sreejithmunthikodu/Mechatronics-MASc-Course-Project/final_design_report.pdf

### University of Victoria

Department of Mechanical Engineering

MECH 458/554 - Mechatronics

# Design and Implementation of an Inspection System Using an ATMEL AVR Microcontroller

# Final Design Report

Rushi Nathvani

V00835408

Sreejith Munthikodu

V00903589

## April 19, 2018

# Abstract

Modern embedded systems have become a vital part of our daily life with their applications ranging from

portable devices such as digital watches and digital cameras to large and complex installations such as traffic

lights, washing machines, and automotive systems. The objective of this design project was to design a high-

performance inspection system, implement the proposed design using an ATMEL AVR microcontroller and to

demonstrate it’s functionality. The inspection system was required to sort given number of items based on the

visual and material characteristics in a minimum amount of time. The project required to use the advanced

microcontroller functionalities such as Interrupts, Timers, Pulse Width Modulation (PWM) and Analog to

Digital Converters (ADC). Also, advanced programming skills were required to implement functions such as

First-In-First-Out (FIFO) dynamic linked list using C-language. Moreover, the project demanded using various

sensors such as inductance and reflectance sensors, and actuators such as a DC motor to drive the conveyor

belt and a stepper motor to rotate the bin to collect the sorted items.

# Acknowledgments

This highly challenging embedded system design project would not have been possible without the ample

guidance of course instructor Mr. Yuanye Chen and lab instructor Mr. Patrick Chang. The concepts required to

complete the project were effectively introduced in sequence in the class and the same was implemented during

the weekly lab sessions. So by the end of lab 4, we could gain a lot of knowledge about the microcontrollers

and their functionalities and we were in a position to start our design project with confidence.

We are highly grateful to Mr. Patrick Chang for patiently listening to all our queries and guiding us to find

the right answers from the manual. He sacrificed his weekends and opened the lab on all the weekends which

helped us to spend more time on our project and complete it in time. We would like to thank the University of

Victoria and the Department of Mechanical Engineering for offering such a valuable course, for providing us the

technical manuals and access to the Mechatronics lab and for providing other infrastructures such as the library,

which helped us to successfully complete this design project. Also, we would like to extend our gratitude to all

the Teaching Assistants for helping us to complete our lab works and for extending their support in evaluating

assignments, supervising the exams and for evaluating the demonstration of the inspection system. Finally, we

would like to thank our coursemates for being kind enough to share the limited available stations and other

resources at the lab.

# Contents

## Page

List of Figures | i
List of Tables | i
1 Introduction | 1
2 Project Timeline | 4
3 Methods and Design Approach | 4
4 System Technical Details | 6
5 System Performance Specifications | 11
6 Testing and Calibration Procedures | 12
7 Limitations and System Trade-offs | 13
8 Novel System Additions | 13
9 Experience and Recommendations | 14
10 Conclusion | 15
11 References | 15
Appendix A | Summary of Contributions
Appendix B | Source Code

# List of Figures

## Page

1 | ATMEL AT90USB 1287 MCU | | 2
2 | Model of the conveyor system and inspection stations | | 2
3 | Project timeline | | 4
4 | Block diagram of complete system | | 6
5 | Circuit diagram of complete system | | 7
6 | System algorithm/flowchart | | 8
7 | LCD pins | | 14

# List of Tables

## Page

1 | LCD pin descriptions | | 14
2 | Summary of contributions | A – 1

i

# 1 Introduction

## 1.1 Problem Statement

The objective of this design project was to design a high-performance inspection system, implement the pro-

posed design using an ATMEL AVR microcontroller and demonstrate it’s functionality. The inspection system

was required to sort four types of cylindrically shaped objects which were either black plastic, white plastic,

steel, or aluminum material. For the final performance testing, the inspection system needed to sort 48 of

such items into their respective bins in less than 60 seconds. Also, there had to be a pause button which

paused the inspection system and a ramp-down button which stopped the system after sorting all the items

on the conveyor. The details such as the number of each item sorted and unsorted items on the belt were to

be displayed using LEDs or optionally using LCD display.

## 1.2 Design Purpose and Overview

The purpose of this design project was to classify and sort 48 cylindrical shaped items which were either black

plastic, white plastic, steel, or aluminum in less than 60 seconds. Additionally, a pause button and a system

ramp-down button were required to interrupt the system. The AT90USB 1287 microcontroller was used as

the heart of the sorting system. A conveyor belt driven by a DC motor was used to carry the items to be

sorted through various sensor stations. The sensor stations were used to identify the correct type of the item.

Finally, a stepper motor driven bin was used to collect the sorted items while they fell off the conveyor belt.

The various components used in the design are described below.

## 1.2.1 AT90USB 1287 Microcontroller

The high-performance, low-power Microchip 8-bit AVR microcontroller combines 128KB ISP flash memory with

read-while-write capabilities, 8KB SRAM, 48 general purpose I/O lines, 32 general purpose working registers,

real-time counter, four flexible timer/counters with compare modes and PWM, USB 2.0 low-speed and full-

speed On-The-Go (OTG) host/device, an 8-channel 10-bit A/D converter, JTAG (IEEE 1149.1 compliant)

interface for on-chip debugging, and six software selectable power saving modes. An image of the MCU is

shown in Figure 1.

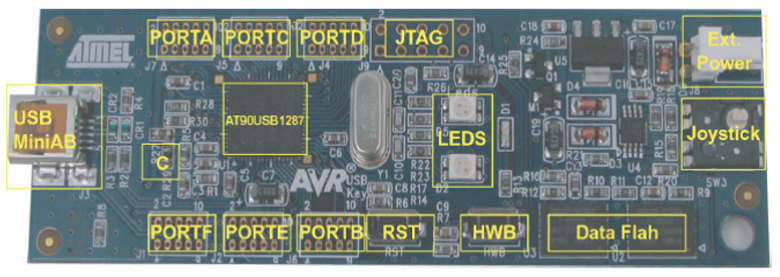
[picture p1: figure]

## Figure 1: ATMEL AT90USB 1287 MCU

## 1.2.2 Conveyor System

A conveyor belt was used to transport the items that were to be sorted. It was driven by a DC motor and

the speed of the conveyor was controlled by the PWM signal. Guides were provided at the loading point of

the conveyor which aligned the loaded items on the belt and ensured that there was a sufficient gap between

adjacent items for the sensors to read correctly. The belt could be started or stopped as required but the speed

of the belt was to be constant during the operation. A model of the system is shown in Figure 2.

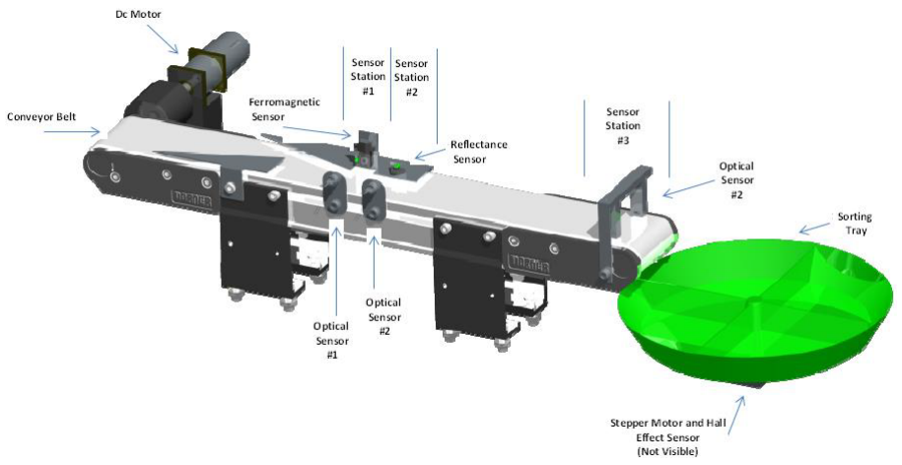
[picture p2: figure]

## Figure 2: Model of the conveyor system and inspection stations

## 1.2.3 Inspection Stations

As the items traveled on the conveyor belt, they passed through various sensor stations which classified the

material and visual characteristics of the items. Three sensors were used in this project to determine the type

of the items.

## - Pre-reflectance Optical Sensor:

It is a digital sensor which is active high. It was used to identify if an item was in the range of the

reflectance sensor. Only when an object was between the pre-reflectance optical sensor and the reflectance

sensor, the analog signal was measured and converted into a digital value.

## - Reflectance Sensor:

It is an analog sensor which measured the reflectance of the item in its range. Based on the visual and

material characteristics, different types of items have their unique range of reflectance value which can

be used to identify the type of the item.

## 1.2.4 Sorting System

There is an exit optical sensor placed near the end of the conveyor belt system. If an item was detected by

the exit optical sensor, which is an active low digital sensor, it indicated that the item has reached the end of

travel. There was a rotating bin below the end of travel which could collect the falling items. If the item at

the end of travel didn’t match the respective tray bin, the belt was stopped and the tray rotated to the correct

bin before starting the belt again and allowing the item to fall down. The location of the bin was identified

by using a Hall-Effect sensor, which set the bin to its home position before the start of the inspection. The

positions of other bins on the tray were defined relative to the home position. The two sensors used in the

## sorting system can be summarized as below:

## - Exit Optical Sensor

It is an active low digital sensor which indicates that the item has reached the end of travel.

## - Hall-Effect Sensor

It is an active low digital sensor that sets the sorting tray to its home position.

# 2 Project Timeline

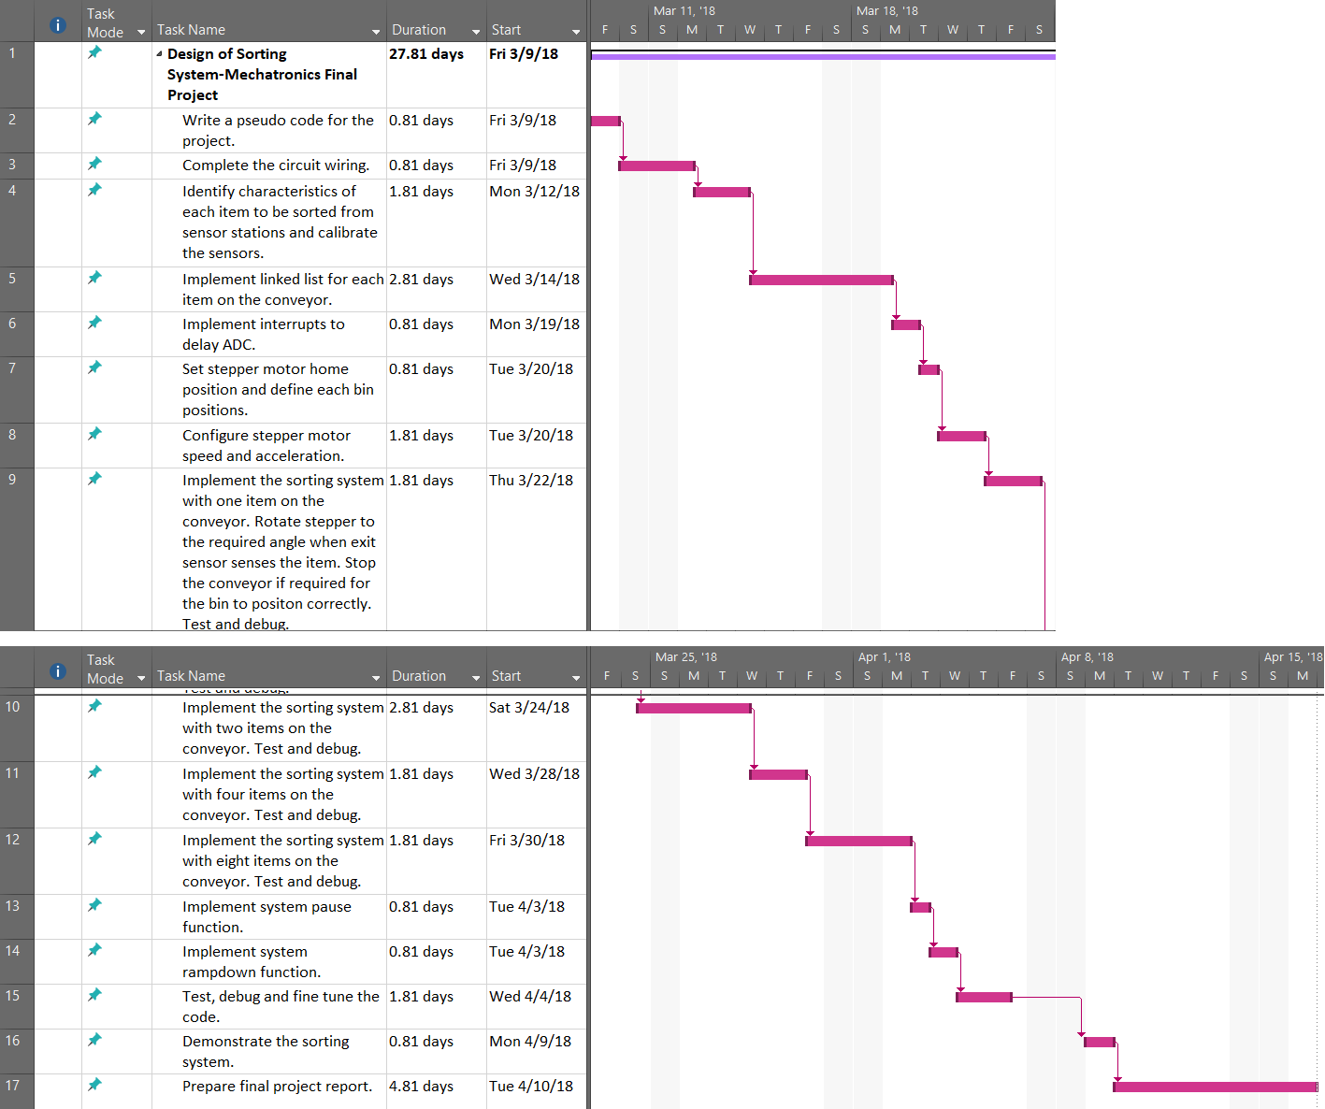
[picture p3: figure]

## Figure 3: Project timeline

# 3 Methods and Design Approach

The design demands a careful coordination of the DC motor, different sensor stations and the stepper motor

for correctly sorting the items on the conveyor. The items were loaded onto the conveyor belt which took them

through the sensor stations. The first sensor station detected the type of the item and the exit sensor station

made sure that the tray was positioned correctly before the item was allowed to fall down into the bin.

The conveyor belt was driven by a DC motor using PWM signal. The speed of the DC motor was controlled

by the width of the PWM signal. The speed was optimized for minimum traveling time with the time available

for the ADC as a constraint. Having a faster belt speed resulted in overlapping ADC reflectance values for the different objects and hence resulted in identifying incorrect object type. Also, at very high speed, when

the belt was stopped at the exit sensor, the object sometimes slipped and fell into the incorrect bin due to the

higher inertia caused by the faster belt speed.

The reflectance sensor was primarily used to identify the type of the item. It is an analog sensor and hence

Analogue to Digital Conversions were required. A 10-bit ADC resolution was used in this project. Since the

ADC consumes considerable process cycles, the pre-reflectance optical sensor was used to ensure that the ADC

started only when an item was present in the range of the reflectance sensor. As the items moved through

the belt and reached the first sensor station, which was the pre-reflectance optical sensor and the reflectance

sensor, ADC was started and the minimum value of the ADC result was stored. As the item left the first

sensor station and traveled on its way to the exit sensor, the MCU compared the minimum ADC result value

with that of the range of each item to be sorted and identified the object type. A dynamic FIFO linked list

was created and the object type was enqueued.

When the object reached the exit optical sensor station, the first item in the linked list was dequeued and the

object type was read. The object type is counted using a different variable to update the total number of each

item sorted and to identify the number of items remaining on the belt. The object type of the dequeued item

was compared with the current tray position. If the tray position matched that of the object type, the item

was allowed to fall into the correct bin without stopping the conveyor belt. If the current bin did not match

the object type, the belt was stopped and a command was given to the stepper motor to rotate the tray to the

correct bin. Once the correct bin was positioned, the belt was started and the object allowed to fall into the

correct bin.

The Hall-Effect sensor set the home position of the bin which was black. Other bin positions were defined

relative to the home position and the stepper was turned 90 degrees clockwise, 90 degrees counterclockwise or

180 degrees as required to set the bin to the correct position before the object was dropped.

The design is mainly interrupt driven. A large chunk of the code is executed inside the interrupts. The first

interrupt is triggered when the item is detected by the pre-reflectance optical sensor. The second interrupt is

triggered when an ADC is completed. A third interrupt is triggered when the object is detected by the exit

optical sensor. The fourth and fifth interrupts are used for the system pause button and system ramp-down

button respectively.

For the system pause, a push-button triggered an interrupt on rising edge when activated. When the pushbutton

is pressed and released, the interrupt stops the conveyor belt immediately and displays the information such as

the number of each object type sorted and the total number of items remaining on the belt. When the button

is pressed and released again, the belt resumes and the system continues to sort items.

Another pushbutton was used for the system ramp-down function. When the interrupt is triggered by the

pushbutton, the systems starts counting and after a set delay the belt is stopped and the sorted item information

is displayed on the LCD screen. The delay in stopping the conveyor belt ensures that all items remaining on

the belt while the system ramp-down is initiated, are sorted before shutting down the system.

# 4 System Technical Details

## 4.1 Block Diagram

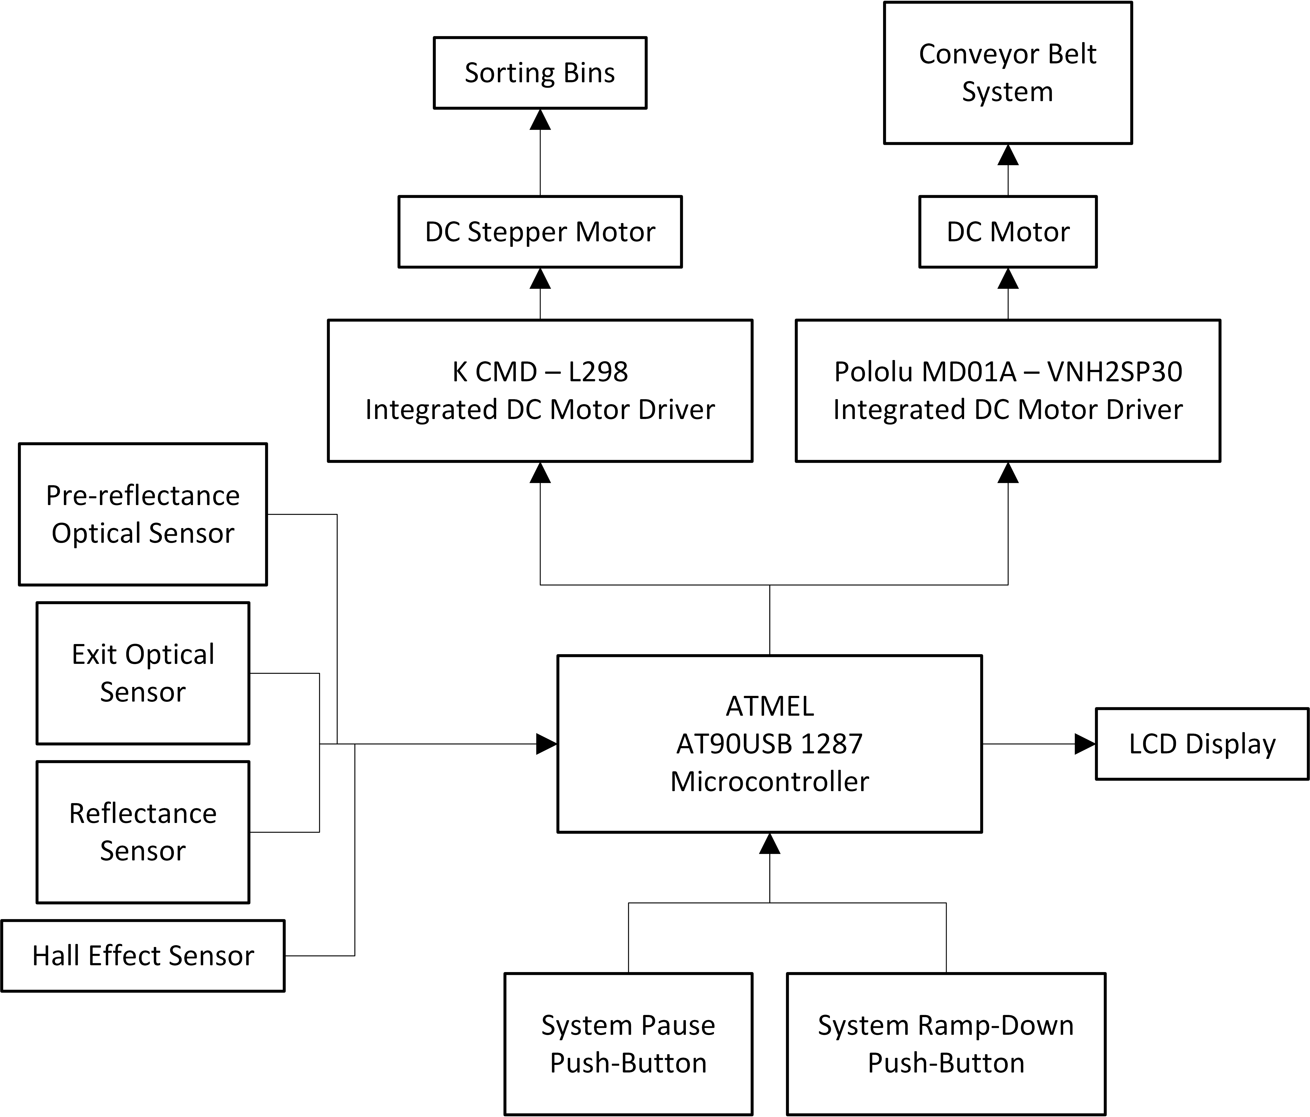
[picture p4: figure]

## Figure 4: Block diagram of complete system

## 4.2 Circuit Diagram

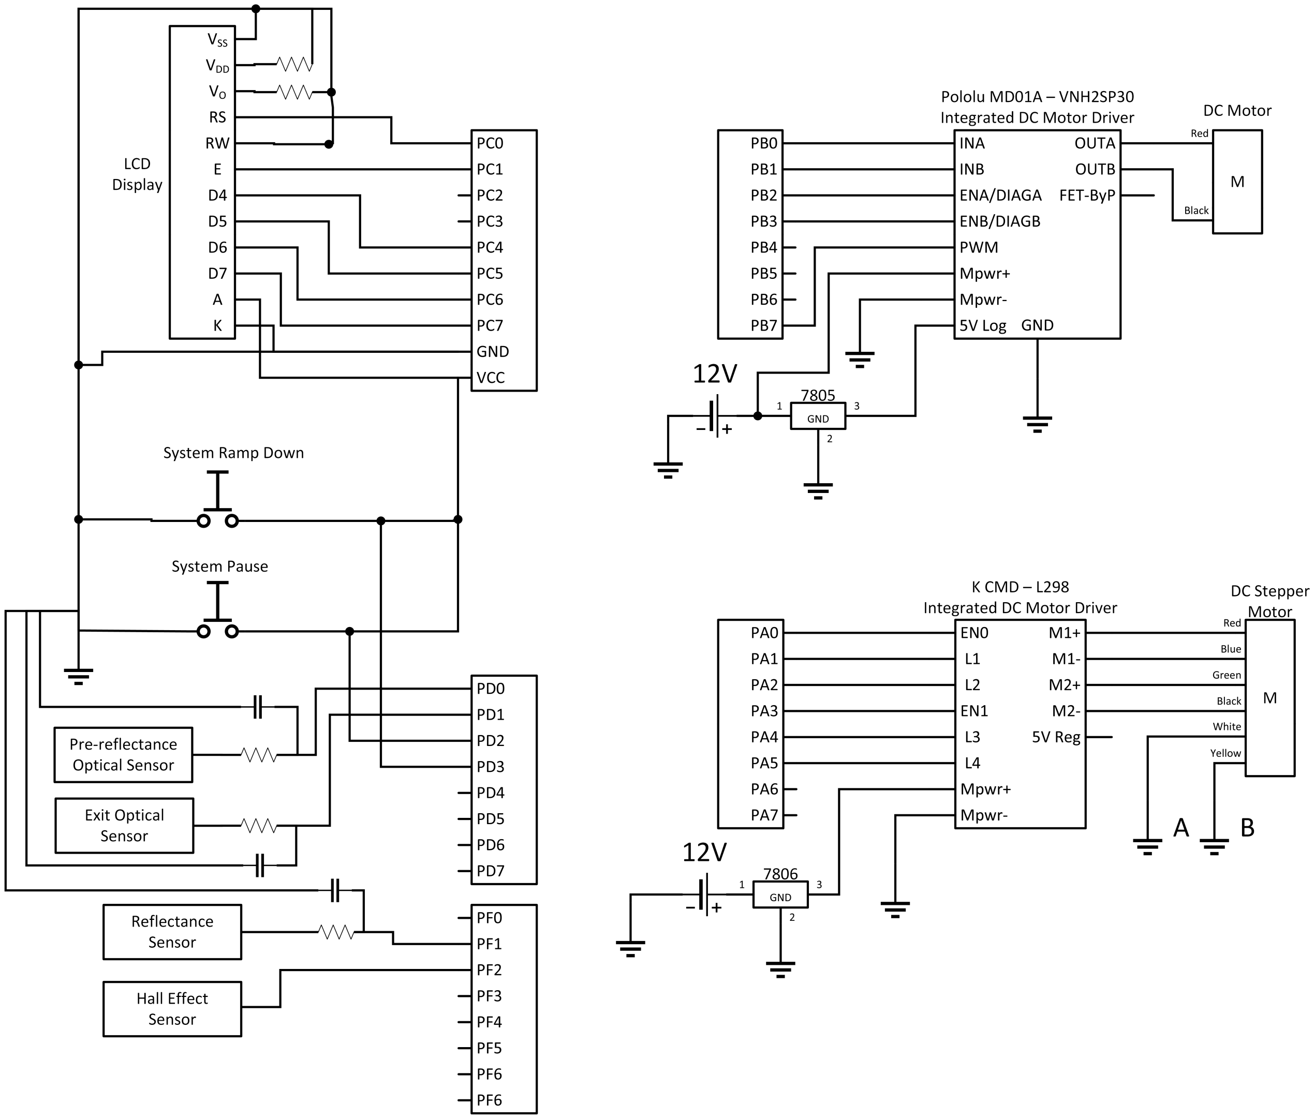
[picture p5: figure]

## Figure 5: Circuit diagram of complete system

## 4.3 System Algorithm/Flowchart

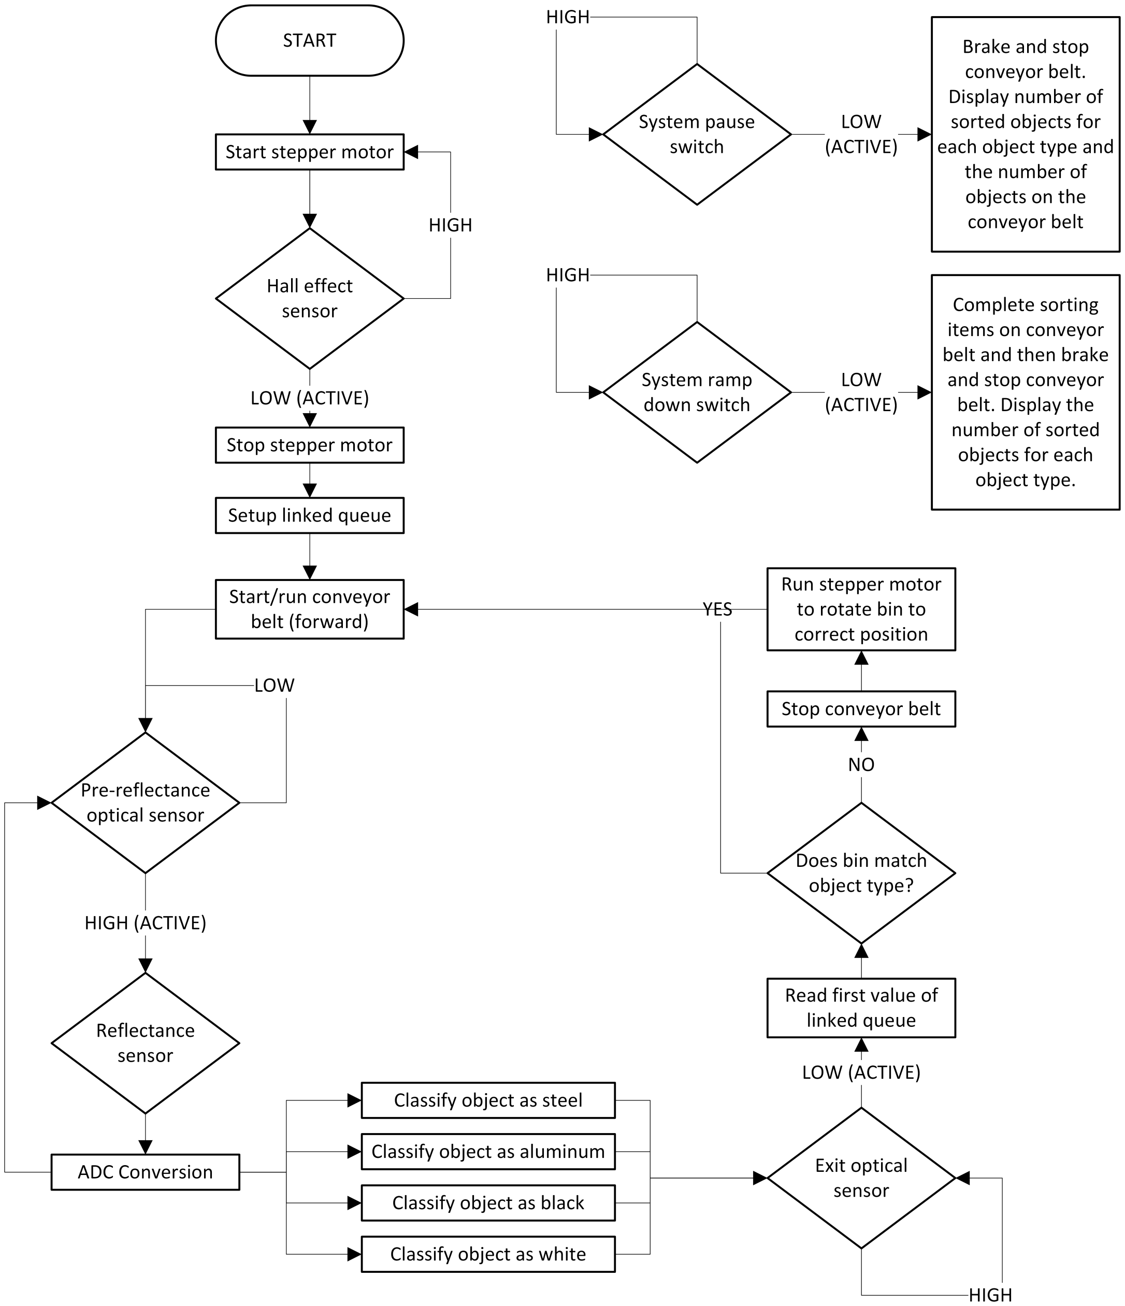
[picture p6: figure]

## Figure 6: System algorithm/flowchart

## 4.4 System Operation

The inspection system uses external power with an input voltage of 6.6V for the stepper motor and DC motor.

Initially, the power to the system is turned on and then the MCU is reset. The system starts with setting the

stepper motor to its home position. Then the conveyor belt is started and the inspection system is ready for

loading items.

Then, items are loaded onto the conveyor belt in batches, up to 8 items at a time. The items can be placed

as close as possible, as the guides provided on the conveyor, will ensure sufficient gap between adjacent items.

As the items pass through the sensor stations, the analog sensor reads the reflectance value of the item. The

MCU then identifies the type of the item based on the reflectance value and updates the information in a FIFO

dynamic linked list. As the item reaches the exit optical sensor, the first item on the linked list is dequeued,

and the object type is compared to the current bin position. If required, the conveyor is stopped and the

stepper is rotated to adjust the bin to its correct position and then the conveyor belt is restarted and the

object is allowed to fall and collected in the appropriate bin.

Due to the limitation of the code in handling the linked list, we had to ensure that the last object of the current

batch of 8 items had reached the exit optical sensor before the first item of the next batch of 8 items reached

the pre-reflectance optical sensor.

## 4.5 Technical Description

The technical descriptions of the various components and functionalities used in this design are described

## below:

## - DC Motor

A brushed DC motor is used to drive the conveyor belt that which carry the items that are to be sorted.

The speed of the motor is controlled using a PWM signal. Dual full bridge driver L298 which can

accept standard TTL logic levels is used to drive the DC motor. Two enable inputs are available in the

interfacing circuit to enable or disable the DC motor independently of their input signals.

## - Pulse Width Modulation (PWM)

Pulse Width Modulation (PWM) helps the MCU to generate a signal with a voltage anywhere between

0V and 3.3V rather than the discrete values of 0V and 3.3V. This can be used to control the input voltage

to devices such as speakers, motors, and LEDs. Based on the input voltage the output of the particular

device vary. For this project, the PWM signal is given to the DC motor. The speed of the DC motor is

dependent on the duty cycle of the PWM signal.

The 8-bit timer of the MCU is used to generate the PWM signal. The timer is set to fast PWM. The

counter TCNT0 is used together with OCR0A to set the duty cycle. The PWM signal is received at the

PIN 7 of PORT B.

## - Timer Delay

A timer function is created to force a delay in the processing. The delay is required for the operation of

the stepper motor, for the display of information using LEDs during the testing phase, for the system

ramp-down function and for synchronizing the movement of the conveyor belt that makes sure that the

previous object is dropped before the belt is stopped for the next item.The 16 bit counter TCNT1 and

output compare register OCR1A are used to create a unit delay of 1 milliseconds.

## - Stepper Motor

A 6V 0.8A unipolar stepper motor is used to rotate the tray for collecting the falling items in the correct

bin. The stepper has a step angle of 1.8 degrees. Though the stepper is unipolar, it is used in a bipolar

mode for maximum torque.

## - Analog to Digital Conversion (ADC)

Analog reflectance sensor is used to measure the reflectance value of the items to be sorted. 10-bit

resolution is used for the ADC. Since the ADC requires a clock frequency between 50 KHz and 200 KHz

for maximum resolution, a pre-scale of 16 is selected for the ADC using the register ADCSRA. The ADC

result is read from the ADC data registers ADCL and ADCH.ADC interrupt is enabled to trigger an

interrupt on completion of one ADC so that another ADC can be started if the item is in the range of

the sensor.

## - Pre-Reflectance Optical Sensor

It is an active high digital sensor that is used to check if an item is in the range of the reflectance sensor.

An ADC is started only when an item is in the range of the analog sensor. This helps to avoid a free

running Analog to Digital Conversion which would have taken a lot of CPU time. A filter is used to filter

out the noise created by the moving parts used in the project.

## - Reflectance Sensor

Reflectance sensor is an analog sensor that measures the reflectance value of the items which are to be

sorted. It is the most critical component in identifying the correct type of the object. A 10 bit ADC

resolution is used to read the reflectance value of the four objects used in this project. A filter is used in

the sensor circuit for filtering out the noise caused by the stepper motor and the DC motor.

## - Exit Optical Sensor

It is an active-low digital sensor used to identify if an object has reached the end of the conveyor belt. An

interrupt is triggered on the exit optical sensor detection that ensures that the bin is correctly positioned

before dropping the item off the conveyor.

## - Hall-Effect Sensor

It is an active low digital sensor used to set the bin to its home position. All other bin locations are defined based on their relative positions from the home bin. The tray is rotated 90 degrees clockwise, 90

degrees counterclockwise or 180 degrees as required for adjusting the bin to its correct position before

dropping the object from the conveyor belt.

## - System Pause Push-button

A push-button is used as the system pause button which disables the DC motor and displays information

about the sorted items in each bin and also about the number of items that are partially processed. The

system resumes sorting once the pause button is pressed again.

## - System Ramp-Down Push-Button

Another pushbutton is used as the system ramp-down button which when activated, will sort all the

items remaining on the conveyor belt and then shuts down the system. The number of objects collected

in each bin is displayed on the LCD after the system is shut down. The inspection system needs to be

reset before restarting.

- LCD Display An LCD display is used to display the number of sorted objects individually by its type

and also the number of unsorted objects.

# 5 System Performance Specifications

The major system performance specifications of the inspection system designed in this project are as follows:

- The final demonstration successfully proved that all the 48 items can be sorted in 45 seconds without

any errors.

- Up to eight objects can be sorted at a time. The system will not give accurate results if both the

exit sensor and the pre-reflectance optical sensor detects items in their range at the same time. Hence

sufficient gap must be maintained before loading another batch of eight items onto the conveyor.

- The conveyor speed cannot be increased beyond the set speed. If a higher speed is used the ADC results

are inaccurate sometimes and also there is a chance of the item slipping due to inertia when the belt is

stopped at the exit sensor. This may lead to the object falling into the wrong bin even if it is identified

correctly by the MCU.

- The stepper uses a very slow acceleration. A faster rate of acceleration was causing the item falling on

the edge of the bin. However, it was identified during the final demonstration that the tray was slightly

misaligned when the bin is set to the home position. Manually correcting the position solved the issue.

However, had this been detected earlier, a faster stepper speed could have been used which could have reduced the time required to sort 48 pieces to possibly less than 40 seconds.

- The inspection system is to be calibrated each time before startup as the ADC can give different results

depending on the time of the day and ambient temperature. It will not cause any issue in identifying

between steel, aluminum, and plastic. But, it may give an error in differentiating between black and

white item.

# 6 Testing and Calibration Procedures

Extensive testing and calibration were done on the system prior to the final demonstration to make sure that

the system sorted all 48 items with zero errors in the minimum possible time. Calibration of the reflectance

proved to be the most critical task in the set up of the system as an error would result in classifying it as

the incorrect object type. We used a LCD display for the final demonstration to display the details of items

sorted. However, for the calibration of the relectance sensor, we used 8 LEDs on PORTC and the 2 inbuilt

LEDs on PORTD as this was only a one-time activity before start-up of the system. A separate code was

maintained for calibration. The 10-bit ADC values were stored in a spreadsheet for each item type and after

multiple trials, the range of reflectance values corresponding to each object type were identified and updated

on the main code.

The reflectance range of steel, aluminum, and the plastics were sufficiently spread apart and hence the system

never gave any errors in differentiating between them. However, the range of black plastic and white plastic

were very close and hence frequent calibrations were required to make sure that the system identified the item

types correctly.

Due to noise created by the DC motor and stepper motor, the ADC and other sensors were sometimes giving

false errors and sometimes triggered false interrupts. When discussed with Mr. Patrick Chang, the lab instruc-

tor, about these issues, he explained what noise and other interferences can disrupt the system performance

and he also explained to us how to remove such noises. We then used low-pass filters to filter out the noises

from the sensors which then started giving correct readings without any random errors.

The optimization of the stepper and DC motor speed was also a challenging task. We tried various acceleration

values for the stepper. However, at high speeds, the stepper was so fast that the items were falling on the

edges. However, later it was found that the tray home position was slightly misaligned. This problem was

identified and corrected only during the demonstration and hence we could not use a fast stepper acceleration

which compromised on the time required to sort the pieces.

Different conveyor speeds were tried by varying the PWM signal. Finally, an optimum speed of the belt was identified. Beyond this speed, items were slipping off the belt at the exit sensor when the belt was stopped

and also, the reflectance sensor was giving less accurate readings due to less available time for ADC to read

the reflectance sensor values.

# 7 Limitations and System Trade-offs

## The major limitations and trade-offs of the design are summarized below:

- The major limitation of the system was that it could not sort items with continuous loading. The items

needed to be loaded in batches of 8 for the inspection system to work accurately. This was due to a

limitation in the code which was unable to handle two simultaneous interrupts - one by the exit optical

sensor to dequeue the linked list and one by the pre-reflectance optical sensor to initiate a new link in

the FIFO linked list. This significantly increased the time required to sort the items.

- The inspection system only used the reflectance sensor for differentiating the different items. Though it

was sufficient for identifying object type between steel, aluminum and plastic materials, it was not always

very accurate in differentiating between white plastic and black plastic items as their reflectance values

were much closer. Hence frequent calibrations were required for the system to work 100% accurately.

- Very high DC motor drive speed could not be used due to the shorter available time for the ADC and

also due to the items slipping off the belt when stopped at the exit sensor. This compromised on the

time required for sorting items as the travel time was higher.

- The acceleration of the stepper was not very impressive. A higher acceleration and hence speed of stepper

turns were causing the items to fall on the edges of the bin. This could have been avoided by carefully

calibrating the tray to its home position.

# 8 Novel System Additions

## LCD Display

The system pause and system ramp-down functions need to display the details of the items sorted in each

bin and the number of partially sorted items if any. The project objectives require using LEDs to display

these numbers. However, an option is given to display the information on an LCD display which would fetch

additional marks. We successfully implemented the LCD display and showed all the required information on

the LCD display rather than using the LEDs.

From a technical perspective, the LCD was implemented using the SPI library and connected to PORT C of

the MCU, in place of the original 8 LEDs. An open-source library was found from the Internet, which allowed

us to easily implement the LCD display. The library code is shown in Listing 12 of Appendix B.

The LCD was connected to the MCU as shown in the circuit diagram in Figure 5. The LCD and its pins are

shown in Figure 7 and its pin descriptions are given in Table 1.

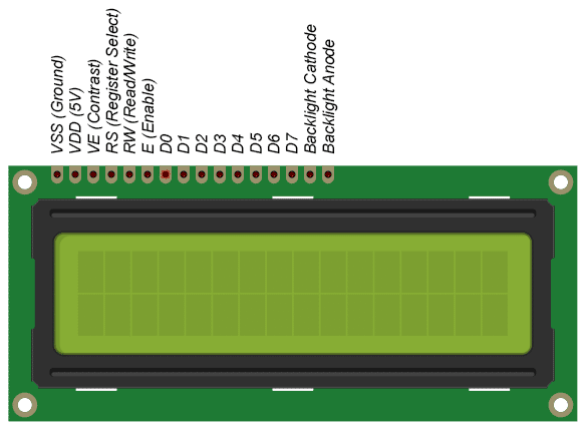
[picture p7: figure]

## Figure 7: LCD pins

Pin | Description
VSS | Ground (0V)
VDD | Supply voltage (5V)
VE | Contrast adjustment
RS | Register Select; selects the command register or display register
RW | Read/Write; selects to write to the register or to read from the register
E | Enable; sends data to data pins
D0-D7 | 8-bit data pins (only pins D4-D7 were used in the project)
K | Backlight cathode; backlight VCC (5V)
A | Backlight anode; backlight ground (0V)

## Table 1: LCD pin descriptions

# 9 Experience and Recommendations

Our overall experience in this project was very positive. We gained many new skills related to embedded

systems, programming, and mechatronics.

Although we consider the conveyor system to he well-designed and robust, some improvements could be made

with the sensors. The sensors sometimes provided incorrect readings even after using low-pass filters. With regards to the whole lab-experience, we have no recommendations. All labs and milestones were well-designed

to allow students to learn effectively.

# 10 Conclusion

The final design of the inspection system successfully met all the requirements set for the project. All the

48 pieces were sorted in 45 seconds without any errors. The system pause function and system ramp-down

functions were successfully demonstrated. Also, all the details of items sorted and items remaining on the belt

were displayed correctly on the LCD display.

The design of this embedded system was very challenging and at the same time highly rewarding. The project

demanded the use of advanced programming skills and a very good knowledge of microcontrollers. The whole

course was so well designed that every day we learned something new which helped us to complete the project.

The confidence that the successful demonstration of this project gave us was enormous. We got a chance to learn

about the microcontroller architecture, Analog-to-Digital Converter (ADC), Pulse Width Modulation (PWM),

Interrupts, Timers, implementation of a linked list in C using pointers, various sensors, and actuators. We are

confident that we have learned enough from this course on how to interface between sensors, actuators, and

MCU and on how to configure MCU registers for using the various functionalities, to take up more challenging

tasks using microcontrollers. The most impressive aspect of this project was learning tonnes of new things by

doing something very interesting and fun.

# 11 References

1. User manual for ATMEL 8-bit AVR Microcontrollers with 64/ 128K Bytes of ISP Flash and USB con-

troller.

2. AT90USBKey Hardware user guide.

Appendix A | Summary of Contributions
Task | Completed by
Sensor calibration | Rushi & Sreejith
Linked list implementation | Rushi & Sreejith
Stepper motor acceleration & deceleration | Sreejith
LCD display | Rushi
System pause & system ramp-down push-button implementation | Rushi & Sreejith
Testing & debugging | Rushi & Sreejith
Project timeline | Sreejith
Block diagram, circuit diagram, & system algorithm/flowchart | Rushi

## Table 2: Summary of contributions

A – 1

Appendix B | Source Code
1 | #include <avr/interrupt.h>
2 | #include <avr/io.h>

3
4 | // Global Variables
5 | volatile char STATE;
6 | volatile uint16_t ADC_result;
7 | volatile unsigned int ADC_result_flag;
8 | volatile unsigned int PAUSE;
9 | volatile unsigned int STATION;

10
11 | volatile uint16_t reflectanceTemp;
12 | volatile uint16_t minADC;

13
14 | //volatile unsigned int i =0;
15 | volatile unsigned int objectCount;
16 | volatile unsigned int countAlum;
17 | volatile unsigned int countSteel;
18 | volatile unsigned int countWhite;
19 | volatile unsigned int countBlack;

## Listing 1: main.h

1 | #include "main.h"
2 | #include "LinkedQueue.h"
3 | #include "mTimer.h"
4 | #include "init.h"
5 | #include "motors.h"
6 | #include "lcd.h"

7
8 int main(){

9
10 | STATE = 0;
11 | PAUSE = 0;
12 | STATION = 8;
13 | position = 4;
14 | mindelay =6;
15 | maxdelay =27;

16
17 | objectCount = 0;
18 | countAlum = 0;
19 | countSteel = 0;
20 | countWhite = 0;
21 | countBlack = 0;

22
23 | cli(); | // Disables all interrupts

24
25 | DDRA = 0xff; //Set PORTA to output for stepper motor
26 | DDRB = 0xff; //Set PORTB to output for DC motor
27 | DDRC = 0xff; //Set PORTC to output for LCD
28 | DDRD = 0b11110000; //Set PORTD to input for 4 sensors and 2 push buttons (default)

29
30 | rotate_cw(101);
31 | initStepperMotor(); // initialize stepper motor to home position
32 | currentBin = 3;
33 | initPWM(); // initialize PWM
34 | initInterrupts(); // initialize interrupts
35 | startDCMotor(); // start DC motor
36 | initADC(); // initialize ADC
37 | initLinkedQueue(); // initialize linked queue
38 | configSensors(STATION); // set sensor thresholds based on station

39

41 | // Enable all interrupts

B – 1

42 | sei(); | // Note this sets the Global Enable for all interrupts

43
44 | goto POLLING_STAGE;

45
46 | // POLLING STATE
47 | POLLING_STAGE:
48 | switch(STATE){
49 | case (0) :
50 | goto POLLING_STAGE;
51 | break; | //not needed but syntax is correct
52 | case (1) :
53 | goto PAUSE_STAGE;
54 | break;
55 | case (2) :
56 | goto RAMPDOWN_STAGE;
57 | break;
58 | case (5) :
59 | goto END;
60 | default :
61 | goto POLLING_STAGE;
62 | }//switch STATE

63
64 | // PAUSE STATE
65 | PAUSE_STAGE:
66 | //Reset the state variable
67 | STATE = 0;
68 | goto POLLING_STAGE;

69
70 | // RAMPDOWN STATE
71 | RAMPDOWN_STAGE:
72 | mTimer(6000);
73 | PORTB = 0x00;
74 | cli();
75 | printLCD();

76
77 | //Reset the state variable
78 | STATE = 0;
79 | goto POLLING_STAGE;

80
81 | END:
82 | // The closing STATE ... how would you get here? ANS: When ramp down button is pressed?
83 | PORTA = 0xF0; | // Indicates this state is active
84 | // Stop everything here...’MAKE SAFE’
85 | return(0);
86 | }

87
88 | // INT0 is triggered by pre-reflectance optical sensor
89 | ISR(INT0_vect){
90 | ADCSRA |= _BV(ADSC); // initialize the ADC, start one conversion
91 | minADC = 0xffff;
92 | objectCount += 1;
93 | }

94
95 | // triggered when each ADC conversion is complete
96 | ISR(ADC_vect){
97 | ADC_result = ADCL | ADCH<<8;
98 | if(ADC_result < minADC){
99 | minADC = ADC_result;
100 | }

101
102 | if((PIND & 0b00000001) == 1){
103 | ADCSRA |= _BV(ADSC); // initialize the ADC, start one conversion
104 | } else {
105 | initLink(&newLink);
106 | newLink->o.reflectance = minADC;
107 | enqueue(&head, &tail, &newLink);

108 | if((newLink->o.reflectance >= minReflectanceAluminum) && (newLink->o.reflectance <
maxReflectanceAluminum)){
109 | newLink->o.objectType = 0;
110 | } else if ((newLink->o.reflectance >= minReflectanceSteel) && (newLink->o.reflectance <
maxReflectanceSteel)){
111 | newLink->o.objectType = 1;
112 | } else if ((newLink->o.reflectance >= minReflectanceWhite) && (newLink->o.reflectance <
maxReflectanceWhite)){
113 | newLink->o.objectType = 2;
114 | } else if ((newLink->o.reflectance >= minReflectanceBlack) && (newLink->o.reflectance <
maxReflectanceBlack)){
115 | newLink->o.objectType = 3;
116 | } else {
117 | while(1){
118 | stopDCMotor();
119 | }
120 | }
121 | STATE = 0;
122 | }
123 | }

124
125 | // INT1 triggered by exit optical sensor
126 | ISR(INT1_vect){
127 | //mTimer(30);
128 | dequeue(&head, &tail, &rtnLink);
129 | if(rtnLink->o.objectType == 0){ // | PORTC = 1;
130 | if(currentBin == 0){
131 | // do nothing
132 | } else if(currentBin == 1){
133 | stopDCMotor();
134 | rotate_cw(100);
135 | } else if(currentBin == 2){
136 | stopDCMotor();
137 | rotate_ccw(50);
138 | } else if(currentBin == 3){
139 | stopDCMotor();
140 | rotate_cw(50);
141 | }
142 | currentBin = 0;
143 | } else if(rtnLink->o.objectType == 1){ // | PORTC = 2;
144 | if(currentBin == 0){
145 | stopDCMotor();
146 | rotate_cw(100);
147 | } else if(currentBin == 1){
148 | // do nothing
149 | } else if(currentBin == 2){
150 | stopDCMotor();
151 | rotate_cw(50);
152 | } else if(currentBin == 3){
153 | stopDCMotor();
154 | rotate_ccw(50);
155 | }
156 | currentBin = 1;
157 | } else if(rtnLink->o.objectType == 2){ // | PORTC = 3;
158 | if(currentBin == 0){
159 | stopDCMotor();
160 | rotate_cw(50);
161 | } else if(currentBin == 1){
162 | stopDCMotor();
163 | rotate_ccw(50);
164 | } else if(currentBin == 2){
165 | // do nothing
166 | } else if(currentBin == 3){
167 | stopDCMotor();
168 | rotate_cw(100);
169 | }

170 | currentBin = 2;
171 | } else if(rtnLink->o.objectType == 3){ | // | PORTC = 4;
172 | if(currentBin == 0){
173 | stopDCMotor();
174 | rotate_ccw(50);
175 | } else if(currentBin == 1){
176 | stopDCMotor();
177 | rotate_cw(50);
178 | } else if(currentBin == 2){
179 | stopDCMotor();
180 | rotate_cw(100);
181 | } else if(currentBin == 3){
182 | // do nothing;
183 | }
184 | currentBin = 3;
185 | }

186
187 | startDCMotor();
188 | mTimer(20);

189
190 | if(rtnLink->o.objectType == 0){ // | PORTC = 1;
191 | countAlum++;
192 | } else if(rtnLink->o.objectType == 1){ // | PORTC = 2;
193 | countSteel++;
194 | } else if(rtnLink->o.objectType == 2){ // | PORTC = 3;
195 | countWhite++;
196 | } else if(rtnLink->o.objectType == 3){ | // | PORTC = 4;
197 | countBlack++;
198 | }

199
200 | objectCount -= 1;
201 | free(rtnLink);
202 | STATE = 0;
203 | }

204
205 | // INT3 triggered by system pause button
206 | ISR(INT2_vect){
207 | mTimer(30); /* Wait 20ms */
208 | while((PIND & 0b00000100) == 0); | /* Wait till button is released */
209 | mTimer(30); /* Wait 20ms */
210 | if(PAUSE == 0){
211 | stopDCMotor();
212 | PAUSE = 1;
213 | STATE = 1;
214 | printLCD();
215 | } else {
216 | startDCMotor();
217 | PAUSE = 0;
218 | STATE = 0;
219 | }
220 | }

221
222 | // INT4 triggered by system ramp-down button
223 | ISR(INT3_vect){
224 | mTimer(30); /* Wait 20ms */
225 | while((PIND & 0b00001000) == 0); | /* Wait till button is released */
226 | mTimer(30); /* Wait 20ms */

227
228 | //rampDown = 1;
229 | STATE = 2;
230 | }

231
232 | ISR(BADISR_vect){
233 | while(1){
234 | Lcd4_Init();
235 | Lcd4_Clear();

236 | Lcd4_Set_Cursor(1,0);
237 | Lcd4_Write_String("********************" );
238 | Lcd4_Set_Cursor(2,0);
239 | Lcd4_Write_String("** | ERROR! | **" );
240 | Lcd4_Set_Cursor(3,0);
241 | Lcd4_Write_String("** | | **" );
242 | Lcd4_Set_Cursor(4,0);
243 | Lcd4_Write_String("********************" );
244 | }
245 | }

## Listing 2: main.c

1 | #include <stdlib.h>
2 | #include <avr/io.h>

3
4 | void initPWM();
5 | void initADC();
6 | void initInterrupts();
7 | void initLinkedQueue();
8 | void configSensors(int station);

9
10 | volatile uint16_t minReflectanceAluminum;
11 | volatile uint16_t maxReflectanceAluminum;
12 | volatile uint16_t minReflectanceSteel;
13 | volatile uint16_t maxReflectanceSteel;
14 | volatile uint16_t minReflectanceWhite;
15 | volatile uint16_t maxReflectanceWhite;
16 | volatile uint16_t minReflectanceBlack;
17 | volatile uint16_t maxReflectanceBlack;

## Listing 3: init.h

1 #include "init.h"

2
3 | void initPWM(){
4 | /* Generating PWM */
5 | TCCR0A|=1<<WGM00|1<<WGM01; | /*Set timer to fast PWM mode, update OCRA at TOP=0xFF*/
6 | //TIMSK0|=0<<OCIE0A; | /*Interrupt is disabled for TCNT0 on A Compare */
7 | //TIFR0|=1<<OCF0A; | /*Reset TIFR0 and initiate counter */
8 | TCCR0A|=1<<COM0A1; | /*Set output mode to non-inverted, OC0A clear on compare, set
| at TOP */
9 | TCCR0B|=1<<CS01; | /*Set Timer pre-scale to 8 | */
10 | OCR0A=90; | /*Duty Cycle out of 255 */
11 | DDRB|=1<<DDB7; | /*Set PORTB PIN7 as output to enable OC0A to control PIN
| output */
12 | }

13
14 | void initADC(){
15 | // by default, the ADC input (analog input is set to be ADC0 / PORTF0
16 | ADCSRA |= _BV(ADEN); // enable ADC
17 | ADCSRA |= _BV(ADIE); // enable interrupt of ADC
18 | ADCSRA |= _BV(ADPS2); // set ADC prescaler to 128
19 | ADMUX |= _BV(REFS0); // set reference voltage to VCC
20 | ADMUX |= _BV(MUX0); // use ADC channel 1
21 | // ADLAR = 0 (default)
22 | }

23
24 | void initInterrupts(){
25 | // config the external interrupt ======================================
26 | EIMSK|= _BV(INT0); // enable INT0 for pre-reflectance optical sensor
27 | EIMSK|= _BV(INT1); // enable INT1 for exit optical sensor
28 | EIMSK|= _BV(INT2); // enable INT2 for system pause PB
29 | EIMSK|= _BV(INT3); // enable INT3 for system ramp-down PB
31 | EICRA |= _BV(ISC01) | _BV(ISC00); // rising edge INT0 for pre-reflectance optical sensor

32 | EICRA |= _BV(ISC11); // falling edge INT1 for exit optical sensor
33 | EICRA |= _BV(ISC21); // falling edge INT2 for system pause PB
34 | EICRA |= _BV(ISC31); // falling edge INT3 for system ramp-down PB
35 | }

36
37 | void configSensors(int station){
38 | if(station == 3){
39 | minReflectanceAluminum = 0;
40 | maxReflectanceAluminum = 400;
41 | minReflectanceSteel = 401;
42 | maxReflectanceSteel = 775;
43 | minReflectanceWhite = 776;
44 | maxReflectanceWhite = 932;
45 | minReflectanceBlack = 933;
46 | maxReflectanceBlack = 0xffff;
47 | } else if(station == 8){
48 | minReflectanceAluminum = 0;
49 | maxReflectanceAluminum = 350;
50 | minReflectanceSteel = 351;
51 | maxReflectanceSteel = 750;
52 | minReflectanceWhite = 751;
53 | maxReflectanceWhite = 936;
54 | minReflectanceBlack = 937;
55 | maxReflectanceBlack = 0xfff;
56 | } else if(station == 11){
57 | minReflectanceAluminum = 130;
58 | maxReflectanceAluminum = 210;
59 | minReflectanceSteel = 520;
60 | maxReflectanceSteel = 640;
61 | minReflectanceWhite = 900;
62 | maxReflectanceWhite = 935;
63 | minReflectanceBlack = 936;
64 | maxReflectanceBlack = 980;
65 | }
66 | }

## Listing 4: init.c

1 | #include <stdlib.h>
2 | #include <avr/io.h>

3
4 | volatile unsigned int position;
5 | volatile unsigned int currentBin;
6 | volatile unsigned int maxdelay;
7 | volatile unsigned int mindelay;

8
9 | void startDCMotor();
10 | void stopDCMotor();
11 | void initStepperMotor();
12 | int rotate_cw(int steps);
13 | int rotate_ccw(int steps);

## Listing 5: motors.h

1 | #include "motors.h"
2 | #include "mTimer.h"
3 | #include "LinkedQueue.h"

4
5 | //function to start DC motor
6 | void startDCMotor(){
7 | PORTB = 0b00000010; // start the conveyor
8 | }

9
10 | //function to stop DC motor
11 | void stopDCMotor(){
12 | PORTB = 0b00000000; // stop the conveyor

13 }

14
15 | //function to initialize bin to home position
16 | void initStepperMotor(){
17 | while((PINF & 0b00000100) == 0b00000100){
18 | rotate_cw(2);
19 | }
20 | }

21
22 | //function for clockwise rotation
23 | int rotate_cw(int steps){
24 | int count=0;
25 | int delay;
26 | int acceleration=1;
27 | int delta;
28 | delta=maxdelay-mindelay;
29 | delay=maxdelay;

30
31 | while(steps>count){
32 | if(position==4){
33 | PORTA= 0b00011011; /*clockwise rotation through 0.9 degrees, M2, L4 energized */
34 | mTimer(delay);
35 | count++;
36 | if ((delay>mindelay)&(acceleration==1)) /* check if in acceleration mode */
37 | {
38 | delay=delay-1; | /* decrease delay by 5 milliseconds or
| accelerate */
39 | }
40 | else if((steps-count)<delta) | /* check if in deceleration mode */
41 | {
42 | delay=delay+1; | /* increase delay by 5 milliseconds or
| accelerate */
43 | acceleration=0; | /* set to deceleration mode */
44 | }
45 | position = 1;
46 | } else if (position==1){
47 | PORTA = 0b00011101; /* half step clockwise rotation through 0.9 degrees, M1, L2
| energized */
48 | mTimer(delay);
49 | count++;
50 | if ((delay>mindelay)&(acceleration==1)) /* check if in acceleration mode */
51 | {
52 | delay=delay-1; | /* decrease delay by 5 milliseconds or
| accelerate */
53 | }
54 | else if((steps-count)<delta) | /* check if in deceleration mode */
55 | {
56 | delay=delay+1; | /* increase delay by 5 milliseconds or
| accelerate */
57 | acceleration=0; | /* set to deceleration mode */
58 | }
59 | position = 2;
60 | } else if (position==2){
61 | PORTA=0b00101101; /*clockwise rotation through 0.9 degrees, M1, L2 energized */
62 | mTimer(delay);
63 | count++;
64 | if ((delay>mindelay)&(acceleration==1)) /* check if in acceleration mode */
65 | {
66 | delay=delay-1; | /* decrease delay by 5 milliseconds or
| accelerate */
67 | }
68 | else if((steps-count)<delta) | /* check if in deceleration mode */
69 | {
70 | delay=delay+1; | /* increase delay by 5 milliseconds or
| accelerate */
71 | acceleration=0; | /* set to deceleration mode */

72 | }
73 | position = 3;
74 | } else if (position==3){
75 | PORTA =0b00101011; /* half step clockwise rotation through 0.9 degrees, M2, L3
| energized */
76 | mTimer(delay);
77 | count++;
78 | if ((delay>mindelay)&(acceleration==1)) /* check if in acceleration mode */
79 | {
80 | delay=delay-1; | /* decrease delay by 5 milliseconds or
| accelerate */
81 | }
82 | else if((steps-count)<delta) | /* check if in deceleration mode */
83 | {
84 | delay=delay+1; | /* increase delay by 5 milliseconds or
| accelerate */
85 | acceleration=0; | /* set to deceleration mode */
86 | }
87 | position = 4;
88 | }// end if
89 | } /* end while */
90 | return(0);
91 | } /* end rotate_ccw */

92
93 | //function for counter clockwise rotation
94 | int rotate_ccw(int steps){
95 | int count=0;
96 | int delay;
97 | int acceleration=1;
98 | int delta;
99 | delta=maxdelay-mindelay;
100 | delay=maxdelay;
101 | while(steps>count){
102 | if(position==4){
103 | PORTA= 0b00101011; /*clockwise rotation through 0.9 degrees, M2, L4 energized */
104 | mTimer(delay);
105 | count++;
106 | if ((delay>mindelay)&(acceleration==1)) /* check if in acceleration mode */
107 | {
108 | delay=delay-1; | /* decrease delay by 5 milliseconds or
| accelerate */
109 | }
110 | else if((steps-count)<delta) | /* check if in deceleration mode */
111 | {
112 | delay=delay+1; | /* increase delay by 5 milliseconds or
| accelerate */
113 | acceleration=0; | /* set to deceleration mode */
114 | }
115 | position = 1;
116 | } else if (position==1){
117 | PORTA = 0b00101101; /* half step clockwise rotation through 0.9 degrees, M1, L2
| energized */
118 | mTimer(delay);
119 | count++;
120 | if ((delay>mindelay)&(acceleration==1)) /* check if in acceleration mode */
121 | {
122 | delay=delay-1; | /* decrease delay by 5 milliseconds or
| accelerate */
123 | }
124 | else if((steps-count)<delta) | /* check if in deceleration mode */
125 | {
126 | delay=delay+1; | /* increase delay by 5 milliseconds or
| accelerate */
127 | acceleration=0; | /* set to deceleration mode */
128 | }
129 | position = 2;

130 | } else if (position==2){
131 | PORTA=0b00011101; /*clockwise rotation through 0.9 degrees, M1, L2 energized */
132 | mTimer(delay);
133 | count++;
134 | if ((delay>mindelay)&(acceleration==1)) /* check if in acceleration mode */
135 | {
136 | delay=delay-1; | /* decrease delay by 5 milliseconds or
| accelerate */
137 | }
138 | else if((steps-count)<delta) | /* check if in deceleration mode */
139 | {
140 | delay=delay+1; | /* increase delay by 5 milliseconds or
| accelerate */
141 | acceleration=0; | /* set to deceleration mode */
142 | }
143 | position = 3;
144 | } else if (position==3){
145 | PORTA =0b00011011; /* half step clockwise rotation through 0.9 degrees, M2, L3
| energized */
146 | mTimer(delay);
147 | count++;
148 | if ((delay>mindelay)&(acceleration==1)) /* check if in acceleration mode */
149 | {
150 | delay=delay-1; | /* decrease delay by 5 milliseconds or
| accelerate */
151 | }
152 | else if((steps-count)<delta) | /* check if in deceleration mode */
153 | {
154 | delay=delay+1; | /* increase delay by 5 milliseconds or
| accelerate */
155 | acceleration=0; | /* set to deceleration mode */
156 | }
157 | position = 4;
158 | }
159 | } /* end while */
160 | return(0);
161 | } /* end rotate_ccw */

## Listing 6: motors.c

1 | #include <stdlib.h>
2 | #include <avr/io.h>

3
4 void mTimer(int count);

## Listing 7: mTimer.h

1 #include "mTimer.h"

2
3 | //########################################################################
4 | //function for timer in milliseconds
5 | void mTimer(int count){
6 | TCCR1B|=(1<<CS10)|(1<<WGM12); //set timer control prescaling to none and mode
7 | //to Clear Time on Compare, CTC.
8 | OCR1A=1000; // Output compare register is set to 1000D.
9 | TCNT1=0; // Initialize counter
10 | //TIMSK1|= (0<<1);//Timer counter output compare A match is disabled.
11 | TIFR1|=(1<<OCF1A); //Timer counter interrupt flag is cleared and timer is started.

12
13 | int i=0; // for counting the loop
14 | while(i<count){
15 | if((TIFR1&(0b00000010))==0b00000010){
16 | TIFR1|=(1<<OCF1A); //Timer counter interrupt flag is cleared.
17 | i++;
18 | }//if
19 | }//while

20 }//mTimer

## Listing 8: mTimer.c

1 | #include <stdlib.h>
2 | #include <avr/io.h>

3
4 | /* Type definitions */
5 | typedef struct {
6 | int objectID; | /* unique ID of object starting from 0 */
7 | int magnetic; | /* 1: object is magnetic (i.e. steel or aluminum), 0: object is not magnetic
(i.e. black or white) */
8 | uint16_t reflectance; | /* reflectance sensor value */
9 | int objectType; /* type of object, 0: aluminum, 1: steel, 2: white, 3: black) */
10 | } object;

11
12 | typedef struct link{
13 | object | o;
14 | struct link *next;
15 | } link;

16
17 | void | initLink | (link **newLink);
18 | void | setup | (link **h, link **t);
19 | void | clearQueue | (link **h, link **t);
20 | void | enqueue | (link **h, link **t, link **nL);
21 | void | dequeue | (link **h, link **t, link **deQueuedLink);
22 | object firstValue | (link **h);
23 | char | isEmpty | (link **h);
24 | int | size | (link **h, link **t);

25
26 | struct link *head; | /* The ptr to the head of the queue */
27 | struct link *tail; | /* The ptr to the tail of the queue */
28 | struct link *newLink; | /* A ptr to a link aggregate data type (struct) */
29 | struct link *rtnLink; | /* same as the above */

## Listing 9: LinkedQueue.h

1 #include "LinkedQueue.h"

2
3 | void initLinkedQueue(){
4 | rtnLink = NULL;
5 | newLink = NULL;
6 | setup(&head, &tail);
7 | }

8
9 | /**************************************************************************************
10 | * DESC: initializes the linked queue to ’NULL’ status
11 | * INPUT: the head and tail pointers by reference
12 | */
13 | void setup(link **h,link **t){
14 | *h = NULL; | /* Point the head to NOTHING (NULL) */
15 | *t = NULL; | /* Point the tail to NOTHING (NULL) */
16 | return;
17 | }/*setup*/

18
19 | /**************************************************************************************
20 | * DESC: This initializes a link and returns the pointer to the new link or NULL if error
21 | * INPUT: the head and tail pointers by reference
22 | */
23 | void initLink(link **newLink){
24 | //link *l;
25 | *newLink = malloc(sizeof(link));
26 | (*newLink)->next = NULL;
27 | return;
28 | }/*initLink*/

30 | /****************************************************************************************
31 | * | DESC: Accepts as input a new link by reference, and assigns the head and tail
32 | * | of the queue accordingly
33 | * | INPUT: the head and tail pointers, and a pointer to the new link that was created
34 | */
35 | /* will put an item at the tail of the queue */
36 | void enqueue(link **h, link **t, link **nL){

37
38 | | if (*t != NULL){
39 | | /* Not an empty queue */
40 | | (*t)->next = *nL;
41 | | *t = *nL; //(*t)->next;
42 | | }/*if*/
43 | | else{
44 | | /* It’s an empty Queue */
45 | | //(*h)->next = *nL;
46 | | //should be this
47 | | *h = *nL;
48 | | *t = *nL;
49 | | }/* else */
50 | | return;
51 | }/*enqueue*/

52
53 | /**************************************************************************************
54 | * DESC : Removes the link from the head of the list and assigns it to deQueuedLink
55 | * INPUT: The head and tail pointers, and a ptr ’deQueuedLink’
56 | * | which the removed link will be assigned to
57 | */
58 | /* This will remove the link and element within the link from the head of the queue */
59 | void dequeue(link **h, link **t, link **deQueuedLink){
60 | | /* ENTER YOUR CODE HERE */
61 | | *deQueuedLink = *h; // Will set to NULL if Head points to NULL
62 | | /* Ensure it is not an empty queue */
63 | | if (*h != NULL){
64 | | *h = (*h)->next;
65 | | }/*if*/

66
67 | | if (*h == NULL){
68 | | *t = NULL;
69 | | }
70 | | return;
71 | }/*dequeue*/

72
73 | /**************************************************************************************
74 | * DESC: Peeks at the first element in the list
75 | * INPUT: The head pointer
76 | * RETURNS: The element contained within the queue
77 | */
78 | /* This simply allows you to peek at the head element of the queue and returns a NULL pointer if
| | empty */
79 | object firstValue(link **h){
80 | | return((*h)->o);
81 | }/*firstValue*/

82
83 | /**************************************************************************************
84 | * DESC: deallocates (frees) all the memory consumed by the Queue
85 | * INPUT: the pointers to the head and the tail
86 | */
87 | /* This clears the queue */
88 | void clearQueue(link **h, link **t){
89 | | link *temp;
90 | | while (*h != NULL){
91 | | temp = *h;
92 | | *h=(*h)->next;
93 | | free(temp);
94 | | }/*while*/

95 | /* Last but not least set the tail to NULL */
96 | *t = NULL;
97 | return;
98 | }/*clearQueue*/

99
100 | /**************************************************************************************
101 | * DESC: Checks to see whether the queue is empty or not
102 | * INPUT: The head pointer
103 | * RETURNS: 1:if the queue is empty, and 0:if the queue is NOT empty
104 | */
105 | /* Check to see if the queue is empty */
106 | char isEmpty(link **h){
107 | /* ENTER YOUR CODE HERE */
108 | return(*h == NULL);
109 | }/*isEmpty*/

110
111 | /**************************************************************************************
112 | * DESC: Obtains the number of links in the queue
113 | * INPUT: The head and tail pointer
114 | * RETURNS: An integer with the number of links in the queue
115 | */
116 | /* returns the size of the queue*/
117 | int size(link **h, link **t){
118 | link | *temp; | /* will store the link while traversing the queue */
119 | int | numObjects;
120 | numObjects = 0;
121 | temp = *h; | /* point to the first item in the list */
122 | while(temp != NULL){
123 | numObjects++;
124 | temp = temp->next;
125 | }/*while*/
126 | return(numObjects);
127 | }/*size*/

## Listing 10: LinkedQueue.c

1 | //LCD Functions Developed by electroSome
2 | #define eS_PORTA0 0
3 | #define eS_PORTA1 1
4 | #define eS_PORTA2 2
5 | #define eS_PORTA3 3
6 | #define eS_PORTA4 4
7 | #define eS_PORTA5 5
8 | #define eS_PORTA6 6
9 | #define eS_PORTA7 7
10 | #define eS_PORTB0 10
11 | #define eS_PORTB1 11
12 | #define eS_PORTB2 12
13 | #define eS_PORTB3 13
14 | #define eS_PORTB4 14
15 | #define eS_PORTB5 15
16 | #define eS_PORTB6 16
17 | #define eS_PORTB7 17
18 | #define eS_PORTC0 20
19 | #define eS_PORTC1 21
20 | #define eS_PORTC2 22
21 | #define eS_PORTC3 23
22 | #define eS_PORTC4 24
23 | #define eS_PORTC5 25
24 | #define eS_PORTC6 26
25 | #define eS_PORTC7 27
26 | #define eS_PORTD0 30
27 | #define eS_PORTD1 31
28 | #define eS_PORTD2 32
29 | #define eS_PORTD3 33
30 | #define eS_PORTD4 34
31 | #define eS_PORTD5 35

32 | #define eS_PORTD6 36
33 | #define eS_PORTD7 37

34
35 | #ifndef D0
36 | #define D0 eS_PORTA0
37 | #define D1 eS_PORTA1
38 | #define D2 eS_PORTA2
39 | #define D3 eS_PORTA3
40 | #endif

41
42 | #include<util/delay.h>
43 | #include "main.h"

44
45 void print_LCD();

## Listing 11: lcd.h

1 | #define D4 eS_PORTC4
2 | #define D5 eS_PORTC5
3 | #define D6 eS_PORTC6
4 | #define D7 eS_PORTC7
5 | #define RS eS_PORTC0
6 | #define EN eS_PORTC1

7
8 #include "lcd.h"

9
10 | void printLCD(){
11 | Lcd4_Init();
12 | Lcd4_Clear();

13
14 | Lcd4_Set_Cursor(1,0);
15 | Lcd4_Write_String("BLK = | WHT= | " );

16
17 | switch (countBlack){
18 | case 0:
19 | Lcd4_Set_Cursor(1,6);
20 | Lcd4_Write_Char(0x30);
21 | break;

22
23 | case 1:
24 | Lcd4_Set_Cursor(1,6);
25 | Lcd4_Write_Char(0x31);
26 | break;

27
28 | case 2:
29 | Lcd4_Set_Cursor(1,6);
30 | Lcd4_Write_Char(0x32);
31 | break;

32
33 | case 3:
34 | Lcd4_Set_Cursor(1,6);
35 | Lcd4_Write_Char(0x33);
36 | break;

37
38 | case 4:
39 | Lcd4_Set_Cursor(1,6);
40 | Lcd4_Write_Char(0x34);
41 | break;

42
43 | case 5:
44 | Lcd4_Set_Cursor(1,6);
45 | Lcd4_Write_Char(0x35);
46 | break;

47
48 | case 6:
49 | Lcd4_Set_Cursor(1,6);
50 | Lcd4_Write_Char(0x36);

51 | break;

52
53 | case 7:
54 | Lcd4_Set_Cursor(1,6);
55 | Lcd4_Write_Char(0x37);
56 | break;

57
58 | case 8:
59 | Lcd4_Set_Cursor(1,6);
60 | Lcd4_Write_Char(0x38);
61 | break;

62
63 | case 9:
64 | Lcd4_Set_Cursor(1,6);
65 | Lcd4_Write_Char(0x39);
66 | break;

67
68 | case 10:
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
503 | PORTB |= (1<<PB5);
504 | else if(a == eS_PORTB6)
505 | PORTB |= (1<<PB6);
506 | else if(a == eS_PORTB7)
507 | PORTB |= (1<<PB7);
508 | else if(a == eS_PORTC0)
509 | PORTC |= (1<<PC0);
510 | else if(a == eS_PORTC1)
511 | PORTC |= (1<<PC1);
512 | else if(a == eS_PORTC2)

513 | PORTC |= (1<<PC2);
514 | else if(a == eS_PORTC3)
515 | PORTC |= (1<<PC3);
516 | else if(a == eS_PORTC4)
517 | PORTC |= (1<<PC4);
518 | else if(a == eS_PORTC5)
519 | PORTC |= (1<<PC5);
520 | else if(a == eS_PORTC6)
521 | PORTC |= (1<<PC6);
522 | else if(a == eS_PORTC7)
523 | PORTC |= (1<<PC7);
524 | else if(a == eS_PORTD0)
525 | PORTD |= (1<<PD0);
526 | else if(a == eS_PORTD1)
527 | PORTD |= (1<<PD1);
528 | else if(a == eS_PORTD2)
529 | PORTD |= (1<<PD2);
530 | else if(a == eS_PORTD3)
531 | PORTD |= (1<<PD3);
532 | else if(a == eS_PORTD4)
533 | PORTD |= (1<<PD4);
534 | else if(a == eS_PORTD5)
535 | PORTD |= (1<<PD5);
536 | else if(a == eS_PORTD6)
537 | PORTD |= (1<<PD6);
538 | else if(a == eS_PORTD7)
539 | PORTD |= (1<<PD7);
540 | }
541 | }

542
543 | //LCD 8 Bit Interfacing Functions
544 | void Lcd8_Port(char a)
545 | {
546 | if(a & 1)
547 | pinChange(D0,1);
548 | else
549 | pinChange(D0,0);

550
551 | if(a & 2)
552 | pinChange(D1,1);
553 | else
554 | pinChange(D1,0);

555
556 | if(a & 4)
557 | pinChange(D2,1);
558 | else
559 | pinChange(D2,0);

560
561 | if(a & 8)
562 | pinChange(D3,1);
563 | else
564 | pinChange(D3,0);

565
566 | if(a & 16)
567 | pinChange(D4,1);
568 | else
569 | pinChange(D4,0);

570
571 | if(a & 32)
572 | pinChange(D5,1);
573 | else
574 | pinChange(D5,0);

575
576 | if(a & 64)
577 | pinChange(D6,1);
578 | else

579 | pinChange(D6,0);

580
581 | if(a & 128)
582 | pinChange(D7,1);
583 | else
584 | pinChange(D7,0);
585 | }

586
587 | void Lcd8_Cmd(char a)
588 | {
589 | pinChange(RS,0); | // => RS = 0
590 | Lcd8_Port(a); | //Data transfer
591 | pinChange(EN,1); | // => E = 1
592 | _delay_ms(1);
593 | pinChange(EN,0); | // => E = 0
594 | _delay_ms(1);
595 | }

596
597 | void Lcd8_Clear()
598 | {
599 | Lcd8_Cmd(1);
600 | }

601
602 | void Lcd8_Set_Cursor(char a, char b)
603 | {
604 | if(a == 1)
605 | Lcd8_Cmd(0x80 + b);
606 | else if(a == 2)
607 | Lcd8_Cmd(0xC0 + b);
608 | }

609
610 | void Lcd8_Init()
611 | {
612 | pinChange(RS,0);
613 | pinChange(EN,0);
614 | _delay_ms(20);
615 | ///////////// Reset process from datasheet /////////
616 | Lcd8_Cmd(0x30);
617 | _delay_ms(5);
618 | Lcd8_Cmd(0x30);
619 | _delay_ms(1);
620 | Lcd8_Cmd(0x30);
621 | _delay_ms(10);
622 | /////////////////////////////////////////////////////
623 | Lcd8_Cmd(0x38); | //function set
624 | Lcd8_Cmd(0x0C); | //display on,cursor off,blink off
625 | Lcd8_Cmd(0x01); | //clear display
626 | Lcd8_Cmd(0x06); | //entry mode, set increment
627 | }

628
629 | void Lcd8_Write_Char(char a)
630 | {
631 | pinChange(RS,1); | // => RS = 1
632 | Lcd8_Port(a); | //Data transfer
633 | pinChange(EN,1); | // => E = 1
634 | _delay_ms(1);
635 | pinChange(EN,0); | // => E = 04
636 | _delay_ms(1);
637 | }

638
639 | void Lcd8_Write_String(char *a)
640 | {
641 | int i;
642 | for(i=0;a[i]!=’\0’;i++)
643 | Lcd8_Write_Char(a[i]);
644 | }

646 | void Lcd8_Shift_Right()
647 | {
648 | Lcd8_Cmd(0x1C);
649 | }

650
651 | void Lcd8_Shift_Left()
652 | {
653 | Lcd8_Cmd(0x18);
654 | }
655 | //End LCD 8 Bit Interfacing Functions

656
657 //LCD 4 Bit Interfacing Functions

658
659 | void Lcd4_Port(char a)
660 | {
661 | if(a & 1)
662 | pinChange(D4,1);
663 | else
664 | pinChange(D4,0);

665
666 | if(a & 2)
667 | pinChange(D5,1);
668 | else
669 | pinChange(D5,0);

670
671 | if(a & 4)
672 | pinChange(D6,1);
673 | else
674 | pinChange(D6,0);

675
676 | if(a & 8)
677 | pinChange(D7,1);
678 | else
679 | pinChange(D7,0);
680 | }
681 | void Lcd4_Cmd(char a)
682 | {
683 | pinChange(RS,0); | // => RS = 0
684 | Lcd4_Port(a);
685 | pinChange(EN,1); | // => E = 1
686 | _delay_ms(1);
687 | pinChange(EN,0); | // => E = 0
688 | _delay_ms(1);
689 | }

690
691 | void Lcd4_Clear()
692 | {
693 | Lcd4_Cmd(0);
694 | Lcd4_Cmd(1);
695 | }

696
697 | void Lcd4_Set_Cursor(char a, char b)
698 | {
699 | char temp,z,y;
700 | if(a == 1)
701 | {
702 | temp = 0x80 + b;
703 | z = temp>>4;
704 | y = (0x80+b) & 0x0F;
705 | Lcd4_Cmd(z);
706 | Lcd4_Cmd(y);
707 | }
708 | else if(a == 2)
709 | {
710 | temp = 0xC0 + b;

711 | z = temp>>4;
712 | y = (0xC0+b) & 0x0F;
713 | Lcd4_Cmd(z);
714 | Lcd4_Cmd(y);
715 | }
716 | }

717
718 | void Lcd4_Init()
719 | {
720 | Lcd4_Port(0x00);
721 | _delay_ms(20);
722 | ///////////// Reset process from datasheet /////////
723 | Lcd4_Cmd(0x03);
724 | _delay_ms(5);
725 | Lcd4_Cmd(0x03);
726 | _delay_ms(11);
727 | Lcd4_Cmd(0x03);
728 | /////////////////////////////////////////////////////
729 | Lcd4_Cmd(0x02);
730 | Lcd4_Cmd(0x02);
731 | Lcd4_Cmd(0x08);
732 | Lcd4_Cmd(0x00);
733 | Lcd4_Cmd(0x0C);
734 | Lcd4_Cmd(0x00);
735 | Lcd4_Cmd(0x06);
736 | }

737
738 | void Lcd4_Write_Char(char a)
739 | {
740 | char temp,y;
741 | temp = a&0x0F;
742 | y = a&0xF0;
743 | pinChange(RS,1); | // => RS = 1
744 | Lcd4_Port(y>>4); | //Data transfer
745 | pinChange(EN,1);
746 | _delay_ms(1);
747 | pinChange(EN,0);
748 | _delay_ms(1);
749 | Lcd4_Port(temp);
750 | pinChange(EN,1);
751 | _delay_ms(1);
752 | pinChange(EN,0);
753 | _delay_ms(1);
754 | }

755
756 | void Lcd4_Write_String(char *a)
757 | {
758 | int i;
759 | for(i=0;a[i]!=’\0’;i++)
760 | Lcd4_Write_Char(a[i]);
761 | }

762
763 | void Lcd4_Shift_Right()
764 | {
765 | Lcd4_Cmd(0x01);
766 | Lcd4_Cmd(0x0C);
767 | }

768
769 | void Lcd4_Shift_Left()
770 | {
771 | Lcd4_Cmd(0x01);
772 | Lcd4_Cmd(0x08);
773 | }
774 | //End LCD 4 Bit Interfacing Functions

## Listing 12: lcd.c
