sreejithmunthikodu/Mechatronics-MASc-Course-Project/lcd.c

#define D4 eS_PORTC4
#define D5 eS_PORTC5
#define D6 eS_PORTC6
#define D7 eS_PORTC7
#define RS eS_PORTC0
#define EN eS_PORTC1

#include "lcd.h"

void printLCD(){
	Lcd4_Init();
	Lcd4_Clear();

	Lcd4_Set_Cursor(1,0);
	Lcd4_Write_String("BLK =    WHT=  " );

	switch (countBlack){
		case 0:
		Lcd4_Set_Cursor(1,6);
		Lcd4_Write_Char(0x30);
		break;

		case 1:
		Lcd4_Set_Cursor(1,6);
		Lcd4_Write_Char(0x31);
		break;

		case 2:
		Lcd4_Set_Cursor(1,6);
		Lcd4_Write_Char(0x32);
		break;

		case 3:
		Lcd4_Set_Cursor(1,6);
		Lcd4_Write_Char(0x33);
		break;

		case 4:
		Lcd4_Set_Cursor(1,6);
		Lcd4_Write_Char(0x34);
		break;

		case 5:
		Lcd4_Set_Cursor(1,6);
		Lcd4_Write_Char(0x35);
		break;

		case 6:
		Lcd4_Set_Cursor(1,6);
		Lcd4_Write_Char(0x36);
		break;

		case 7:
		Lcd4_Set_Cursor(1,6);
		Lcd4_Write_Char(0x37);
		break;

		case 8:
		Lcd4_Set_Cursor(1,6);
		Lcd4_Write_Char(0x38);
		break;

		case 9:
		Lcd4_Set_Cursor(1,6);
		Lcd4_Write_Char(0x39);
		break;

		case 10:
		Lcd4_Set_Cursor(1,6);
		Lcd4_Write_Char(0x31);
		Lcd4_Set_Cursor(1,7);
		Lcd4_Write_Char(0x30);
		break;

		case 11:
		Lcd4_Set_Cursor(1,6);
		Lcd4_Write_Char(0x31);
		Lcd4_Set_Cursor(1,7);
		Lcd4_Write_Char(0x31);
		break;

		case 12:
		Lcd4_Set_Cursor(1,6);
		Lcd4_Write_Char(0x31);
		Lcd4_Set_Cursor(1,7);
		Lcd4_Write_Char(0x32);
		break;

		default:
		Lcd4_Set_Cursor(1,6);
		Lcd4_Write_Char(0x30);
	}

	switch (countWhite){
		case 0:
		Lcd4_Set_Cursor(1,14);
		Lcd4_Write_Char(0x30);
		break;

		case 1:
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
		else if(a == eS_PORTC4)
		PORTC |= (1<<PC4);
		else if(a == eS_PORTC5)
		PORTC |= (1<<PC5);
		else if(a == eS_PORTC6)
		PORTC |= (1<<PC6);
		else if(a == eS_PORTC7)
		PORTC |= (1<<PC7);
		else if(a == eS_PORTD0)
		PORTD |= (1<<PD0);
		else if(a == eS_PORTD1)
		PORTD |= (1<<PD1);
		else if(a == eS_PORTD2)
		PORTD |= (1<<PD2);
		else if(a == eS_PORTD3)
		PORTD |= (1<<PD3);
		else if(a == eS_PORTD4)
		PORTD |= (1<<PD4);
		else if(a == eS_PORTD5)
		PORTD |= (1<<PD5);
		else if(a == eS_PORTD6)
		PORTD |= (1<<PD6);
		else if(a == eS_PORTD7)
		PORTD |= (1<<PD7);
	}
}

//LCD 8 Bit Interfacing Functions
void Lcd8_Port(char a)
{
	if(a & 1)
	pinChange(D0,1);
	else
	pinChange(D0,0);

	if(a & 2)
	pinChange(D1,1);
	else
	pinChange(D1,0);

	if(a & 4)
	pinChange(D2,1);
	else
	pinChange(D2,0);

	if(a & 8)
	pinChange(D3,1);
	else
	pinChange(D3,0);

	if(a & 16)
	pinChange(D4,1);
	else
	pinChange(D4,0);

	if(a & 32)
	pinChange(D5,1);
	else
	pinChange(D5,0);

	if(a & 64)
	pinChange(D6,1);
	else
	pinChange(D6,0);

	if(a & 128)
	pinChange(D7,1);
	else
	pinChange(D7,0);
}

void Lcd8_Cmd(char a)
{
	pinChange(RS,0);             // => RS = 0
	Lcd8_Port(a);             //Data transfer
	pinChange(EN,1);             // => E = 1
	_delay_ms(1);
	pinChange(EN,0);             // => E = 0
	_delay_ms(1);
}

void Lcd8_Clear()
{
	Lcd8_Cmd(1);
}

void Lcd8_Set_Cursor(char a, char b)
{
	if(a == 1)
	Lcd8_Cmd(0x80 + b);
	else if(a == 2)
	Lcd8_Cmd(0xC0 + b);
}

void Lcd8_Init()
{
	pinChange(RS,0);
	pinChange(EN,0);
	_delay_ms(20);
	///////////// Reset process from datasheet /////////
	Lcd8_Cmd(0x30);
	_delay_ms(5);
	Lcd8_Cmd(0x30);
	_delay_ms(1);
	Lcd8_Cmd(0x30);
	_delay_ms(10);
	/////////////////////////////////////////////////////
	Lcd8_Cmd(0x38);    //function set
	Lcd8_Cmd(0x0C);    //display on,cursor off,blink off
	Lcd8_Cmd(0x01);    //clear display
	Lcd8_Cmd(0x06);    //entry mode, set increment
}

void Lcd8_Write_Char(char a)
{
	pinChange(RS,1);             // => RS = 1
	Lcd8_Port(a);             //Data transfer
	pinChange(EN,1);             // => E = 1
	_delay_ms(1);
	pinChange(EN,0);             // => E = 04
	_delay_ms(1);
}

void Lcd8_Write_String(char *a)
{
	int i;
	for(i=0;a[i]!='\0';i++)
	Lcd8_Write_Char(a[i]);
}

void Lcd8_Shift_Right()
{
	Lcd8_Cmd(0x1C);
}

void Lcd8_Shift_Left()
{
	Lcd8_Cmd(0x18);
}
//End LCD 8 Bit Interfacing Functions

//LCD 4 Bit Interfacing Functions

void Lcd4_Port(char a)
{
	if(a & 1)
	pinChange(D4,1);
	else
	pinChange(D4,0);

	if(a & 2)
	pinChange(D5,1);
	else
	pinChange(D5,0);

	if(a & 4)
	pinChange(D6,1);
	else
	pinChange(D6,0);

	if(a & 8)
	pinChange(D7,1);
	else
	pinChange(D7,0);
}
void Lcd4_Cmd(char a)
{
	pinChange(RS,0);             // => RS = 0
	Lcd4_Port(a);
	pinChange(EN,1);            // => E = 1
	_delay_ms(1);
	pinChange(EN,0);             // => E = 0
	_delay_ms(1);
}

void Lcd4_Clear()
{
	Lcd4_Cmd(0);
	Lcd4_Cmd(1);
}

void Lcd4_Set_Cursor(char a, char b)
{
	char temp,z,y;
	if(a == 1)
	{
		temp = 0x80 + b;
		z = temp>>4;
		y = (0x80+b) & 0x0F;
		Lcd4_Cmd(z);
		Lcd4_Cmd(y);
	}
	else if(a == 2)
	{
		temp = 0xC0 + b;
		z = temp>>4;
		y = (0xC0+b) & 0x0F;
		Lcd4_Cmd(z);
		Lcd4_Cmd(y);
	}
}

void Lcd4_Init()
{
	Lcd4_Port(0x00);
	_delay_ms(20);
	///////////// Reset process from datasheet /////////
	Lcd4_Cmd(0x03);
	_delay_ms(5);
	Lcd4_Cmd(0x03);
	_delay_ms(11);
	Lcd4_Cmd(0x03);
	/////////////////////////////////////////////////////
	Lcd4_Cmd(0x02);
	Lcd4_Cmd(0x02);
	Lcd4_Cmd(0x08);
	Lcd4_Cmd(0x00);
	Lcd4_Cmd(0x0C);
	Lcd4_Cmd(0x00);
	Lcd4_Cmd(0x06);
}

void Lcd4_Write_Char(char a)
{
	char temp,y;
	temp = a&0x0F;
	y = a&0xF0;
	pinChange(RS,1);             // => RS = 1
	Lcd4_Port(y>>4);             //Data transfer
	pinChange(EN,1);
	_delay_ms(1);
	pinChange(EN,0);
	_delay_ms(1);
	Lcd4_Port(temp);
	pinChange(EN,1);
	_delay_ms(1);
	pinChange(EN,0);
	_delay_ms(1);
}

void Lcd4_Write_String(char *a)
{
	int i;
	for(i=0;a[i]!='\0';i++)
	Lcd4_Write_Char(a[i]);
}

void Lcd4_Shift_Right()
{
	Lcd4_Cmd(0x01);
	Lcd4_Cmd(0x0C);
}

void Lcd4_Shift_Left()
{
	Lcd4_Cmd(0x01);
	Lcd4_Cmd(0x08);
}
//End LCD 4 Bit Interfacing Functions
