sreejithmunthikodu/Mechatronics-MASc-Course-Project/LinkedQueue.c

#include "LinkedQueue.h"

void initLinkedQueue(){
	rtnLink = NULL;
	newLink = NULL;
	setup(&head, &tail);
}

/**************************************************************************************
* DESC: initializes the linked queue to 'NULL' status
* INPUT: the head and tail pointers by reference
*/
void setup(link **h,link **t){
	*h = NULL;		/* Point the head to NOTHING (NULL) */
	*t = NULL;		/* Point the tail to NOTHING (NULL) */
	return;
}/*setup*/

/**************************************************************************************
* DESC: This initializes a link and returns the pointer to the new link or NULL if error
* INPUT: the head and tail pointers by reference
*/
void initLink(link **newLink){
	//link *l;
	*newLink = malloc(sizeof(link));
	(*newLink)->next = NULL;
	return;
}/*initLink*/

/****************************************************************************************
*  DESC: Accepts as input a new link by reference, and assigns the head and tail
*  of the queue accordingly
*  INPUT: the head and tail pointers, and a pointer to the new link that was created
*/
/* will put an item at the tail of the queue */
void enqueue(link **h, link **t, link **nL){

	if (*t != NULL){
		/* Not an empty queue */
		(*t)->next = *nL;
		*t = *nL; //(*t)->next;
	}/*if*/
	else{
		/* It's an empty Queue */
		//(*h)->next = *nL;
		//should be this
		*h = *nL;
		*t = *nL;
	}/* else */
	return;
}/*enqueue*/

/**************************************************************************************
* DESC : Removes the link from the head of the list and assigns it to deQueuedLink
* INPUT: The head and tail pointers, and a ptr 'deQueuedLink'
* 		 which the removed link will be assigned to
*/
/* This will remove the link and element within the link from the head of the queue */
void dequeue(link **h, link **t, link **deQueuedLink){
	/* ENTER YOUR CODE HERE */
	*deQueuedLink = *h;	// Will set to NULL if Head points to NULL
	/* Ensure it is not an empty queue */
	if (*h != NULL){
		*h = (*h)->next;
	}/*if*/

	if (*h == NULL){
		*t = NULL;
	}
	return;
}/*dequeue*/

/**************************************************************************************
* DESC: Peeks at the first element in the list
* INPUT: The head pointer
* RETURNS: The element contained within the queue
*/
/* This simply allows you to peek at the head element of the queue and returns a NULL pointer if empty */
object firstValue(link **h){
	return((*h)->o);
}/*firstValue*/

/**************************************************************************************
* DESC: deallocates (frees) all the memory consumed by the Queue
* INPUT: the pointers to the head and the tail
*/
/* This clears the queue */
void clearQueue(link **h, link **t){
	link *temp;
	while (*h != NULL){
		temp = *h;
		*h=(*h)->next;
		free(temp);
	}/*while*/
	/* Last but not least set the tail to NULL */
	*t = NULL;
	return;
}/*clearQueue*/

/**************************************************************************************
* DESC: Checks to see whether the queue is empty or not
* INPUT: The head pointer
* RETURNS: 1:if the queue is empty, and 0:if the queue is NOT empty
*/
/* Check to see if the queue is empty */
char isEmpty(link **h){
	/* ENTER YOUR CODE HERE */
	return(*h == NULL);
}/*isEmpty*/

/**************************************************************************************
* DESC: Obtains the number of links in the queue
* INPUT: The head and tail pointer
* RETURNS: An integer with the number of links in the queue
*/
/* returns the size of the queue*/
int size(link **h, link **t){
	link 	*temp;			/* will store the link while traversing the queue */
	int 	numObjects;
	numObjects = 0;
	temp = *h;			/* point to the first item in the list */
	while(temp != NULL){
		numObjects++;
		temp = temp->next;
	}/*while*/
	return(numObjects);
}/*size*/
